haluska/MediaButtons/Arduino/README.md

# Arduino/Teensy MediaButtons

View the repo's primary readme. It's right here: https://github.com/EricThirteen/MediaButtons
