haluska/MediaButtons/Desktop/README.md

# MediaButtons Windows Taskbar Application

### Overview

This simple Windows taskbar application reads the current volume setting and any changes to the volume and sends that to the attached Teensy.

### Environment
* Tested on Windows 10, 11
* Works with Visual Studio 2019 and 2022

### Instructions

* Restore NuGet packages
* Press F5!

### Screenshots

MediaButtons sits in the taskbar:
MediaButtons running in the taskbar

Here's the context menu:
MediaButtons context menu

MediaButtons is running and it's talking to the Teensy:
MediaButtons is communicating with the Teensy

Stop!
Stop MediaButtons

So many options...
MediaButtons configuration screen
