haluska/MediaButtons/images/everything.jpg

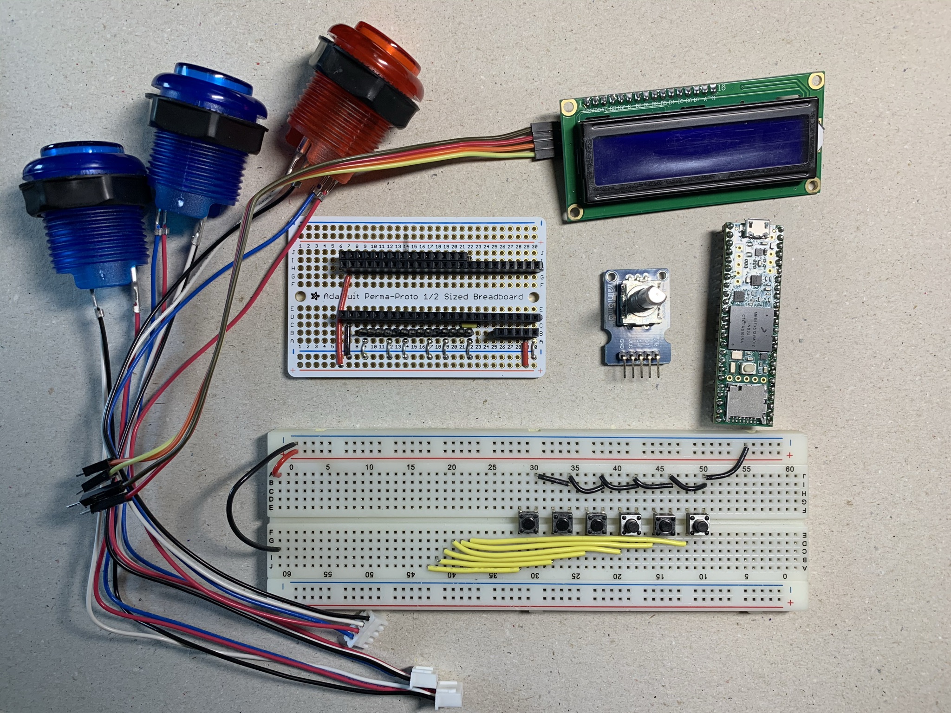
images/everything.jpg
